k4ety/pico_vband/schematic/pico_vband.sch

## KiCad design schematic/pico_vband.sch (2024-02-22, last stored version)

Schematic: pico_vband.sch

Parts:
J1: Morse_Paddle
SW1: Mode_Button
U1: Pico; RPi_Pico_SMD_TH
