k4ety/pico_vband/(commit log)

2024-02-22 First commit. Functional on bare board
    First commit of a reasonably functional vband dongle.
    The major 'missing' feature is a confirmed functional external
    LED, which would currently reduce feature functionality if the
    board were boxed up. That feature will likely be added once I
    box up my board.
    [pico_vband.sch]
2025-02-26 Release v1.0: Note we now do .uf2 file releases
    Add a .uf2 file release to the repository to make the project available
    without having to build from source. Document that in the README.
    Whilst there, also add an extra (better) picture of a built dongle in
    an altoids tin, and make notes in the code and README that you can easily
    swap to an external LED using GPIO9.
    [pico_vband.ino]
2025-07-14 Updated README and build folder to contain .uf2 file
    [pico_vband.sch]
